Pero0123/IOT-Project/Website/project picture.png

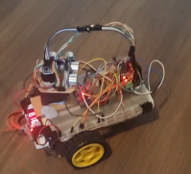
Website/project picture.png
