Pero0123/IOT-Project/Project Report.docx

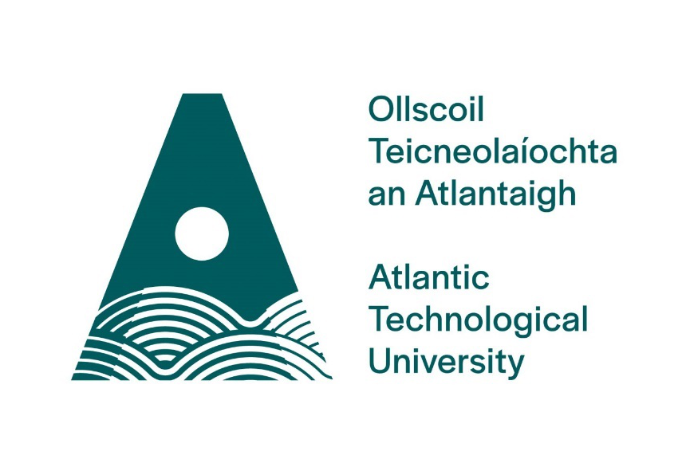
[picture p2: figure]

Autonomous Path Finding Vehicle

Internet of Things Project Proposal

Pero Schwitalla

BEng(H) in Software & Electronic Engineering 2nd Year

Atlantic Technological University

2023/2024

# Autonomous Vehicle Poster

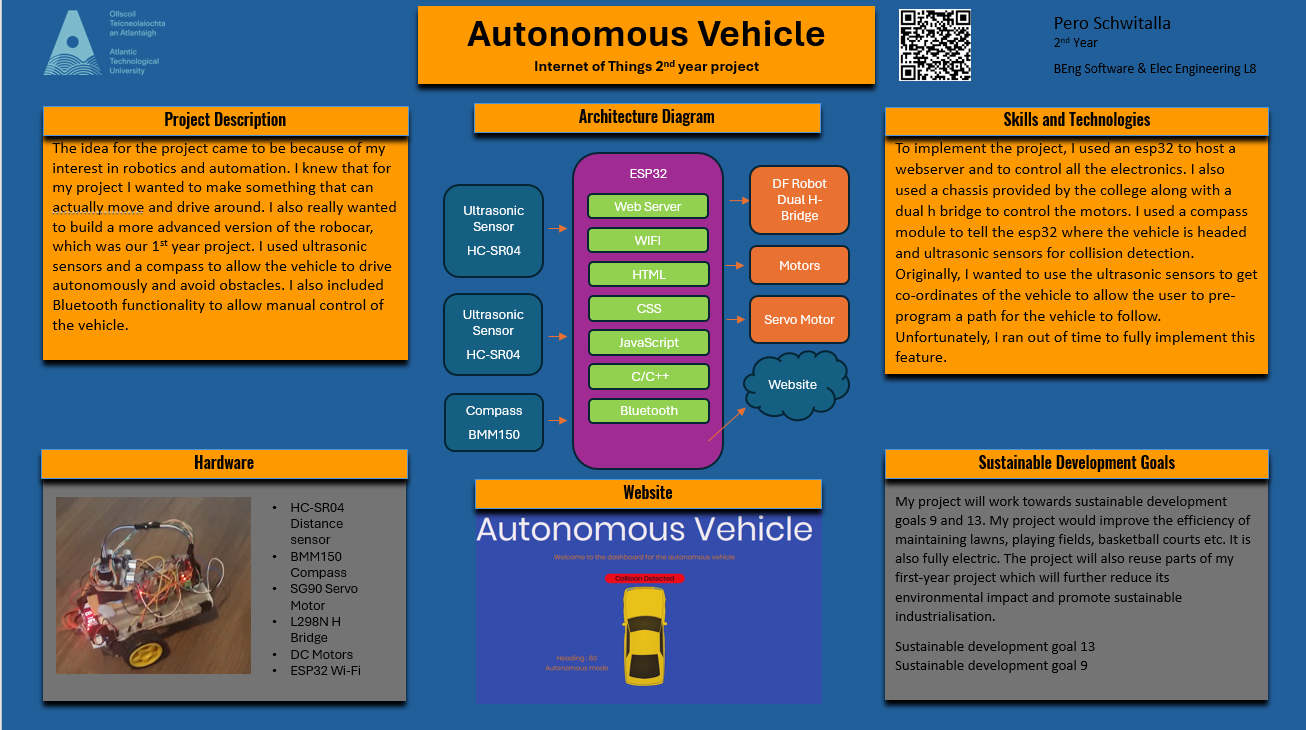
[picture p3: figure]

# Project Hardware

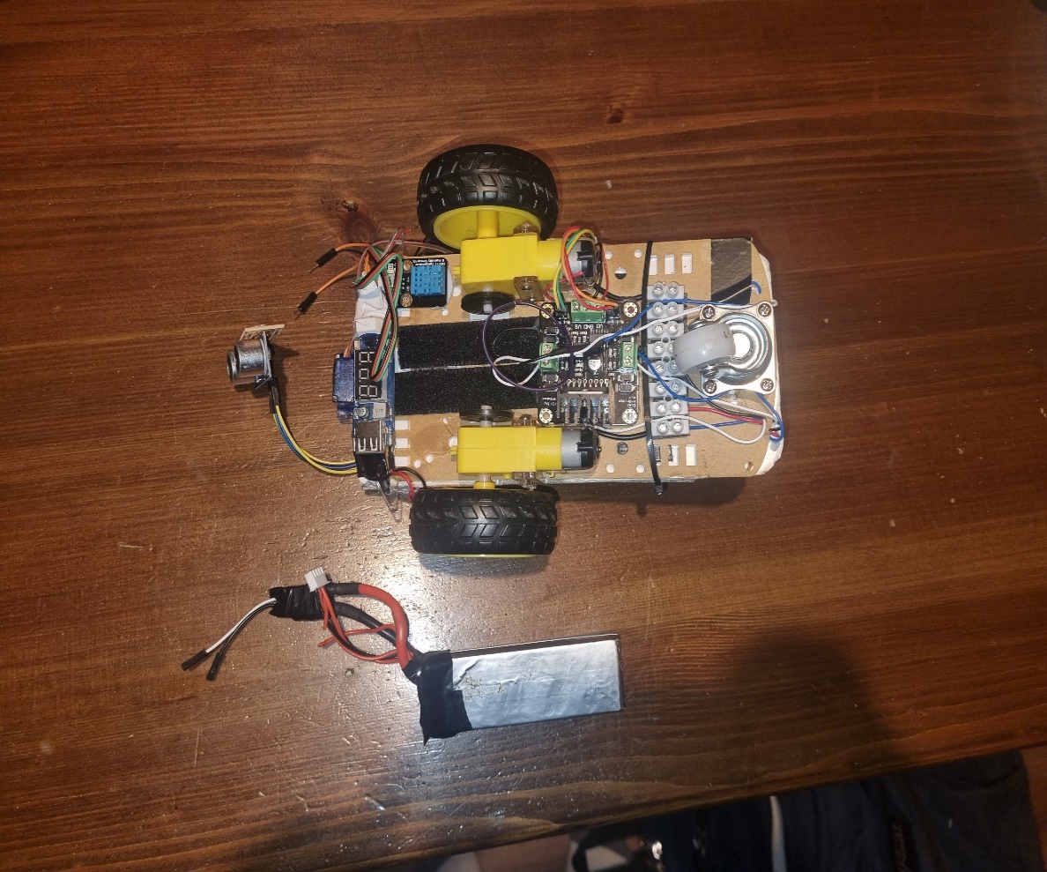
[picture p4: figure]
Bottom view
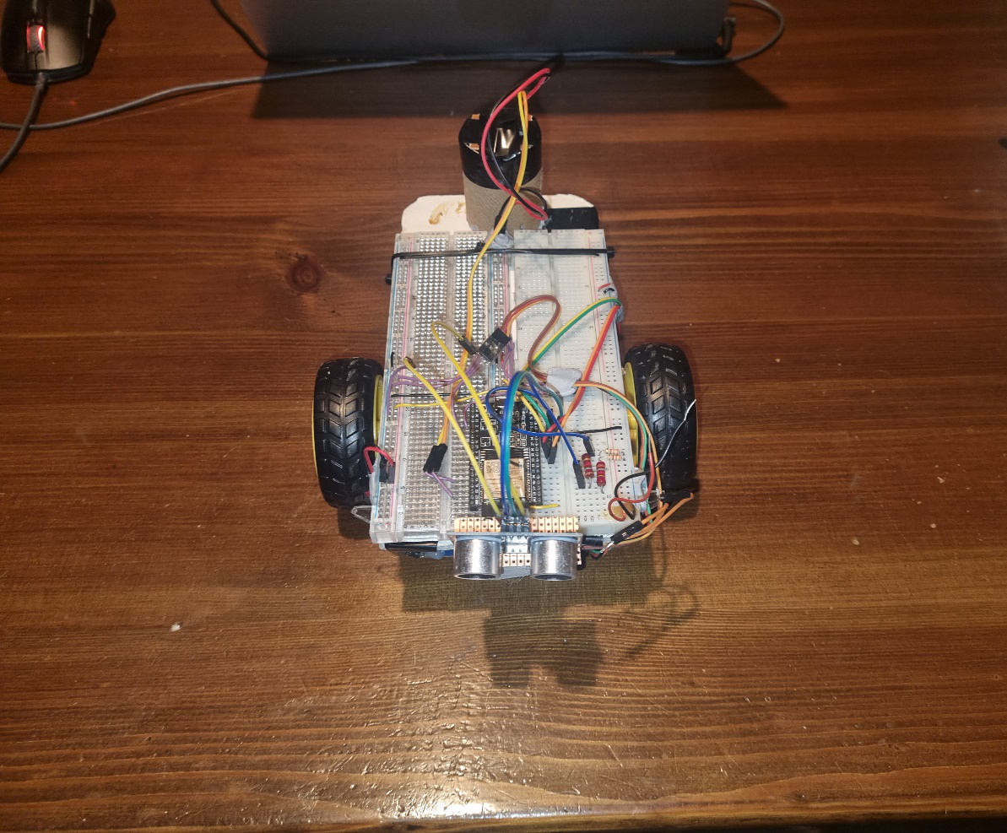
[picture p5: figure]
Top View

# Declaration

This Project is presented is partial fulfilment of the requirements for the degree of Bachelor of Engineering is Software & Electronic Engineering at the Atlantic Technical University, Galway.

This project is my own work, except where otherwise accredited. Where the work of others has been used or incorporated during this project, this is acknowledged and referenced.

# Acknowledgments

I wish to acknowledge and thanks the people who have helped me with this project.

Nathasha Rohan

Brian O’Shea

Brian Contello

Ben Kinsella

Pat Hurney

# 1. Summary

The cleaning and maintenance of lawns, pitches, basketball courts etc are very repetitive tasks which could be automated with the right technology. With an interest in automation and robotics, I am developing an autonomous vehicle platform, which could complete these tasks to a high standard. This will be achieved by using an array of sensors for obstacle detection, environmental monitoring, and navigation. The vehicle will be connected to a webserver, which can used to manually control the vehicle, select the operation mode, and monitor the vehicles status. Telemetry data, such as temperature and humidity can also be viewed on the webpage. This will make it possible to automatically do a wide variety of tasks such as cleaning, cutting grass and ice resurfacing.

The scope of this project involved the integration of hardware and software components to enable the collection and processing of data to autonomously navigate through unknown environments. It also includes the design and implantation of user-friendly interfaces and networking to create a friendly and pleasant user experience.

This project will work towards sustainable development goals 9 and 13. The project would improve the efficiency of maintaining lawns, playing fields, basketball courts etc. It is also fully electric. The project will also reuse parts of previous projects which will further reduce its environmental impact and promote sustainable industrialisation.

1. Sustainable development goal 13 – take urgent action to combat climate change and its impacts.
2. Sustainable development goal 9 – Build resistant infrastructure, promote inclusive and sustainable industrialisation and foster innovation.

I approached this project by breaking it up into separate sections. I wanted to get the sensors working individually before putting it all together. I also created functions to easily use the sensors and control the motors efficiently. Once all the basic functions of the project where individually implemented, I started to build the webpage.

From this project I learned how to deal with noisy data from sensors. I used a magnetometer to create a compass for navigation, but this proved very difficult as signal is very noisy. By calibrating the compass and averaging the values over time I managed to get reliable readings. I also learned that testing and prototyping is very important and can avoid large problems further down the line.

The main technologies used are C/C++ programming, data analyses and processing, noise reduction/blocking, website design, user interface design, Html, CSS, JavaScript fetch API.

I achieved my goal of creating an autonomous vehicle that can be used as a platform for automating certain tasks, however I ran into many problems along the way and had to come up with creative solutions. To achieve this, I had to change the design of the project in major ways.

# 2. Project Plan

I planned the project during the research phase. The plan was altered over time as the project changed during development. However, I stuck to the original plan as closely as I could.

## 2.1 Semester 1 Plan

Week 1 and 2

- In depth research for the project. Acquire components and start testing.

Week 2 and 4

- I will build the ultrasonic location system. I will also research and write the code to find the coordinates of the ultrasonic receivers.

Week 4 and 5

- I will test the accuracy of the ultrasonic location and fix any bugs. I will also begin building the vehicle. If possible, I will use the robocar that I built as my first-year project.

Week 6 and 7

- I will research and code the path finding. I will also write all the functions I need to control the vehicle.

Week 8-10

- I will create a basic implementation of the website. This should include basic features such as manual control, telemetry and have the basic layout of the final webpage. Do a lot of testing and bug fixing during this time to ensure the project is in good shape for the initial project demonstration.

Weeks 11-12

- Finalise the project demonstration and start filming for the demonstration video. Create and edit the demonstration video.

## 2.2 Semester 2 Plan

Week 1

- Order new magnetometer and calibrate it. Test and debug the driveTowardsHeading() function.

Week 2

- Unifi all the drive functions into a single versatile function.
- Continue debugging the compass.

Week 3-5

- add servo for the front ultrasonic sensor. Write to detect obstacles using the ultrasonic sensor.

Week 5-7

- Rebuild the website using flexbox, implement fetch API to send commands from the website back to the ESP32.
- Implement the website controls on the ESP32.
- Send telemetry to the website.

Week 7-9

- Start work on the project poster.

Week 9-12

- Implement obstacle avoidance function.
- Finalise project features.
- Bug testing and tidy up code and website.
- Write project report and film and edit the demonstration video.

## 2.3 Changes to the plan

During development of the project, significant changes were made to the design. As I result the project plan also changed. The removal of the ultrasonic location system was the biggest change. During development of this system, it became apparent that it would be very difficult to implement, and the accuracy was limited to approximately within 5-10 cm during testing.

The alteration to the plan came because of issues with the accuracy and reliability of the magnetometer. I had to order a different sensor and rewrite all the code as result. To avoid this impacting and delaying the rest of the project, I ended putting this part of the project on hold and working on other aspects first.

# 3. Project Architecture

## 3.1Architecture Diagram

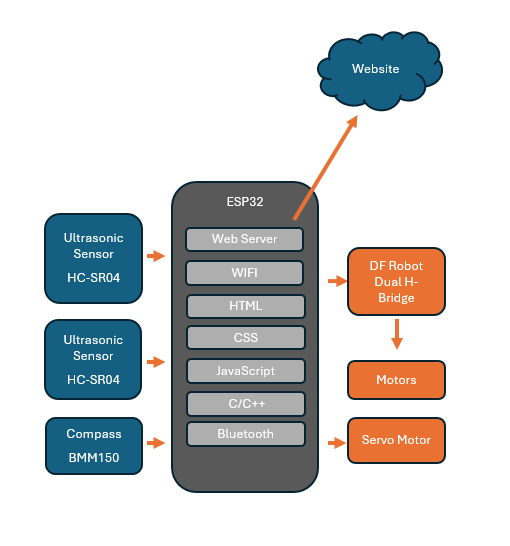
[picture p6: figure]

# 4. Development Platform and Tools

## 4.1 Development Platform

The ESP32 is a low power microcontroller with built it Wi-Fi and Bluetooth capability. It runs at 240Mhz compared to 16Mhz clock speed of the Arduino Uno. These features make it a perfect choice for an IoT project. It allows a responsive web server to run while running the other code simultaneously. It has 4Mb of flash memory allowing large programs and websites to be stored. [1]

## 4.2 Development Platform (IDE)

The ESP32 can be programmed using the Arduino ide, making it easy to develop and build projects with. It also supports many of the same libraries as the Arduino. The Arduino IDE has a versatile serial monitor and code debugger to aid development and testing. The Arduino IDE also allows for easy management of libraries and has support for multiple files, making it easy to write and organise custom functions.

## 4.3 Web Development Platform

To develop the webpage, I used Visual studio code as my code editor. Offers great debugging and supports an extension for a live webpage view, making it easy and quick to make changes the webpage. I also used the Microsoft edge 3D debugger to debug the webpage. This feature makes it easy to debug layering issues Z-index.

Once I finished the webpage, I used the Arduino IDE to store it in literal strings, which can be stored on the ESP32.

## 4.4 Organising and Planning

I used OneNote to keep a development log of my project. I used Trello to make rough long-term plans. This made it easy to get an overview of the whole project at a glance.

# 5. Sensors

I used 3 ultrasonic sensors to detect obstacles in front and to the side of the vehicle. I used a DHT11 to measure temperature and humidity to make distance measurements more accurate and to display the temperature and humidity on the webpage for the user. I also used a magnetometer to detect which way the vehicle is facing.

## 5.1 HSR-04 Ultrasonic Distance Sensors

The HSR-04 provides distance measurement with an accuracy of +-3mm and a field of view of 15 degrees. It operates at 40KHz making it far outside the range of most sounds that could interfere with the measurement. The sensor works by sending out a 40KHz sound in 8 bursts and measuring how long it takes for the signal to return. The output on the Echo pin is in proportion to the time it takes for the signal to return. [2]

To use the ultrasonic sensor a HIGH signal must be applied to the trigger pin for 10us.The Arduin pulseIn() function can then be used to measure the length of the pulse at the Echo pin. The length of the pulse is multiplied by the speed of sound and divided by two to account for the fact the sound has to travel to the object and then back again. The final distance can be calculated using the following formula:

distance = (pulseIn × (340M/S) / 2.

pulseIn is a blocking function. This means that while it is waiting for a pulse, it will effectively stop code execution. To optimize my final code, I adjusted the maximum wait time of pulseIn() to 3000us, which is how long it takes for sound to travel 50cm and back. This means that the maximum amount of time spent waiting for all three sensors to measure a distance will be close to 1ms. Since I don’t need the sensors to measure anything beyond 30cm, it will not have any effect on the functionality of my project. To detect if pulseIn timed out or an obstacle is close, I check if pulseIn returned a 0 or a non-zero value.

## 5.1.1 Ultrasonic Sensor code

## 5.2 DHT-11 Temperature Sensor

The DHT-11 is a temperature and humidity sensor with an accuracy of +-2 degrees Celsius and +- 5%RH. The DHT-11 uses a thermistor and a capacitive humidity sensor for measuring. The output is a digital signal using a proprietary communication protocol [3]. It is used in this project to adjust the distance calculations for the ultrasonic sensors as the speed of sound is dependent on the temperature and humidity of the air it is traveling through [4]. The DHT11 can operate at both 3.3 volt and at 5v. I choose to operate it at 5v as the ESP32 input pin work between 0 and 3.3v.

## 5.2.1 DHT11 Code

## 5.3 QMC5883L Magnetometer

The QMC5883L is a three-axis magnetic sensor. It is a surface mount device that is mounted on a breakout board for easy installation. It is targeted for high precision applications such as virtual reality gaming, drones and robot use. It supports the I2C interface for data transfer. The sensor operates between 2.16V and 3.6V with a low power consumption of 75uA. [5]

In this project it is used to determine the direction the vehicle is heading. This allows me to keep the vehicle driving in a specific direction and to make precise turns, removing the need to precisely calibrate the motor speed to turn a specific direction. The main downside to using a magnetometer to determine the vehicle heading is that it is extremely sensitive to magnetic and electromagnetic fields. To work around this issue, the sensor is mounted on a pole on the back of the vehicle to keep it away from the motors and any other electro magnetic interference. Using magnetic shielding was considered, but it has limited effectiveness and is expensive.

## 5.3.1 QMC5883L Code

# 6. Motors

I used two 360-degree servo motors as propulsion for my vehicle. Originally, I used two dc motors with a dual H-bridge, but this turned out to be difficult to control precisely. The main issue was that, when running the dc motors at a low duty rate it was very difficult to keep them both moving at the same speed leading to the vehicle veering to one side. The relatively large dc motors also caused large current spikes which could shut of the ESP32 momentarily, causing the program to reset. Using 360 servo motors allows for easy and accurate control of the vehicle while preventing any large current spike due to the small motors and high gear ratio. This allows me to use a smaller battery and simply the code and hardware.

## 6.1 Servo Motors

The parallax continues rotation servo (#900-00008) is a non-encoded 360-degree servo motor. It can operate between 0 and 50 rpm clockwise and anticlockwise. It operates between 4V and 6V DC. To control the speed of the servo, a PWM signal is applied to the signal pin. A HIGH pulse of 1.3ms turns the servo at full speed clockwise. A High Pulse of 1.7ms turns the servo at full speed counterclockwise. To stop the servo, a 1.5ms HIGH pulse is applied to the signal pin. [6]

To use the parallax servo in my project, I made use of a modified Servo library [7]. This allows me to use the servoWrite() function to control the speed and direction of the servo motor. Since the library is originally designed to be used with regular 180 degree servos, an angle between 0 and 180 degrees is used as the argument is the servoWrite() function. To stop the servo, the argument is 90 degrees. For full speed clockwise rotation, the argument is 0 degrees and for full speed anti-clockwise rotation, the argument is 180 degrees.

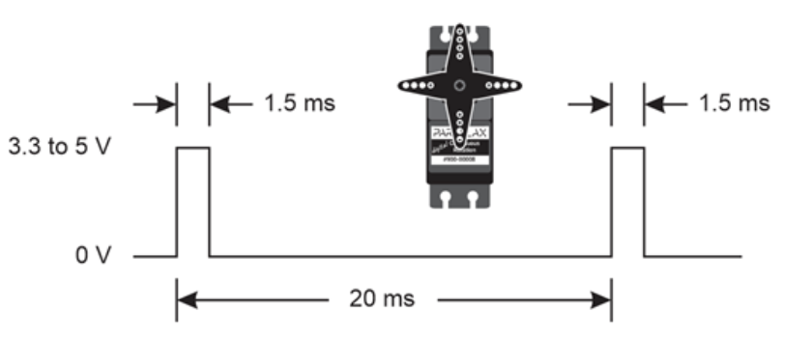
[picture p7: figure]
Servo PWM control signal diagram

## 6.1.1 Servo Code

# 7. Web Server

# 8. Problem Solving

While working on the project, I encountered many problems and complications. A few weeks into the project I realized that the scope of the project is too big and that I would not be able to successfully implement every feature at a high quality. After testing and prototyping the ultrasonic location system, it became apparent that it was a very complex system to get right. I decided to focus on other aspects of the project first and later decided to remove the location system all together.

To solve problems in my project, I worked with other students and with lecturers. I also used numerus online resources such as the Arduino forums, datasheets, and guides to help diagnose and fix problems. Below I outlined the major problems I encountered while working on the project.

## 8.1 Magnetometer Interference

The QMC5883 was giving very unreliable readings when using the example provided by the library I was using. I found out that the specific gy271 breakout board that I sourced was using the cheaper QMC5883L sensor instead of the HMC5883L sensor. I sourced a library designed for this sensor and found it more accurate but still unreliable.

After some experimentation I found that placing the sensor on a pillar on the back of the vehicle away from the magnets in the motor fixed this issue and I got reliable and accurate readings from the compass.

I considered using magnetic shielding foil, but shielding is expensive and less reliable than just placing the sensor away from any interference. The sensor can’t be entirely shielded either because it needs to be able to read earth’s magnetic field to be used as a compass.

## 8.2 Ultrasonic Location System

Splitting the ultrasonic sensors into transmitter and receiver pairs was effective when the sensors were pointed directly are each other. When the sensors were pointed more than 5 or 10 degrees away from each other, they gave inaccurate readings by about +- 2cm per degree. I modified one of the transmitters and receivers to have a wider field of view. This resulted in slightly more accurate readings but still not good enough for my application. Since I was unable to find a solution that was within the scope of this project, I had to cut the location and path finding aspect from my project. Below are two images of the modified sensors.

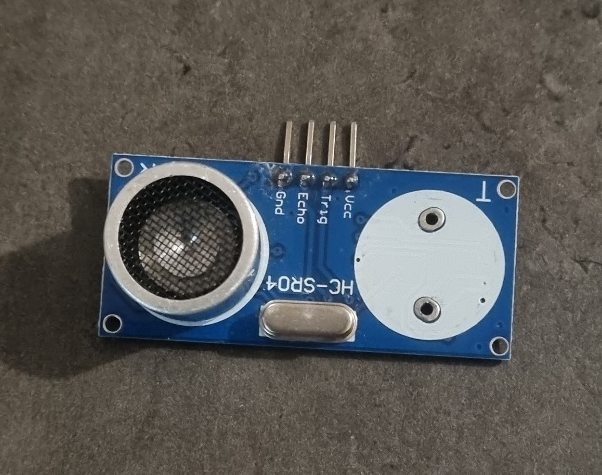
[picture p8: figure]
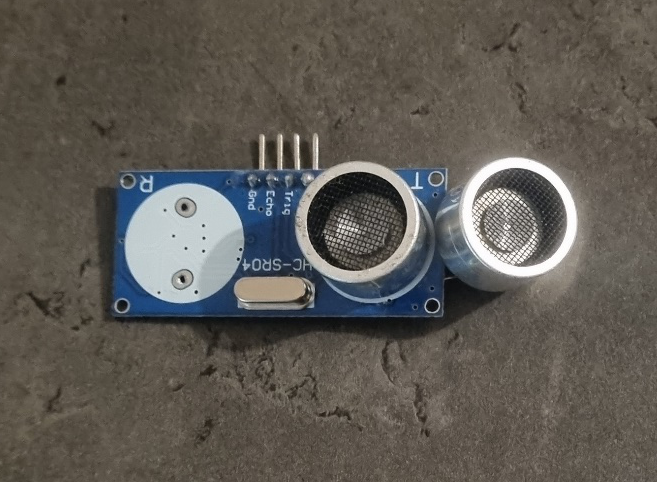
[picture p9: figure]

## 8.3 Vehicle Veering to one side

The vehicle was always veering to the right and then snapped back to the original heading. Initially I thought this was an issue with the compass drifting, or interference. After investigating the problem further I realised that the left DC motor was slightly slower than the right motor causing the vehicle to always veer slightly to the right. Initially to solve this problem, I ran the left motor with a slightly higher duty cycle by about 10%. This improved the problem, but it still wasn’t perfect, and it wasn’t a clean solution and made the code more complicated and messier.

I decided to use continues rotation servos instead of the DC motors for my final hardware. Servo motors are extremely precise and easy to code. Servo motors are also easy to control at low speeds while DC motors are very unreliable at a duty cycle of less than 30%, which is still faster than I want the project to drive at.

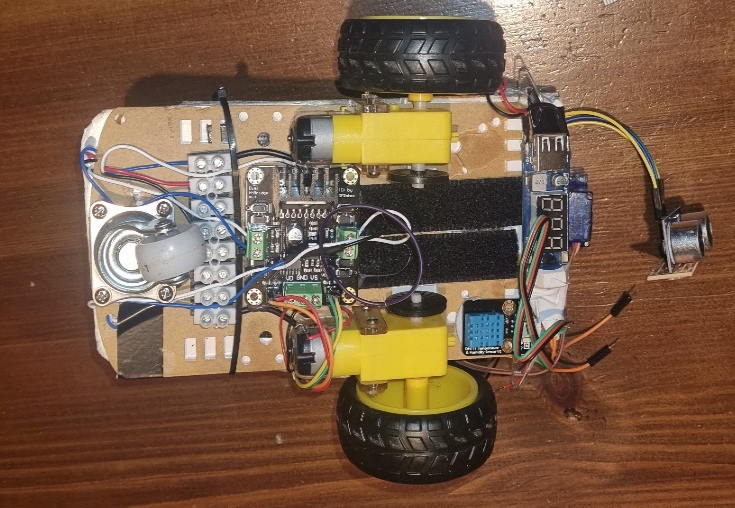
[picture p10: figure]
Bottom view

Figure 1 Project with DC motors and H-Bridge

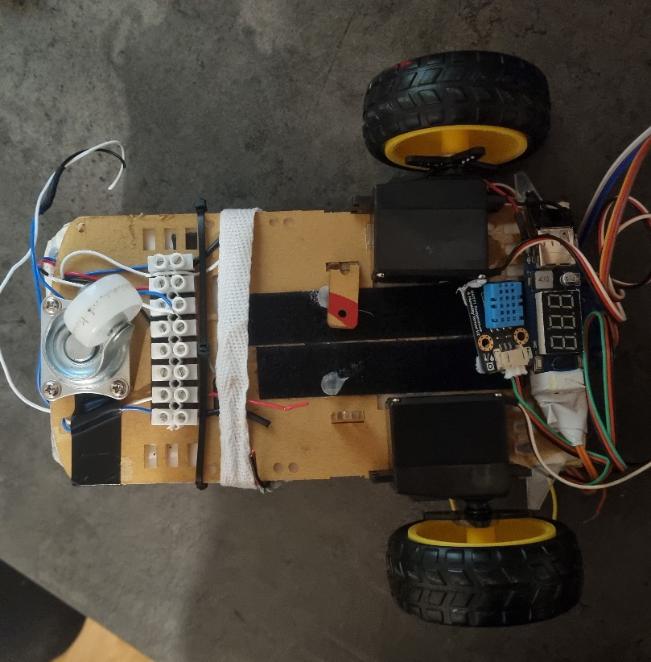
[picture p11: figure]

Figure 2 Project with Servo Motors

## 8.4 ESP32 not connecting to PC

Near the end of the project, the ESP32 stopped connecting to the pc or laptop. I tried using multiple USB cables, updating the Arduino IDE and using different computer. I then tried the legacy version of the Arduino IDE, which gave me an error code relating to the bios mode when trying to upload my code. I locked up the error and found a forum post with a solution. Holding the boot button on the ESP32 while uploading code solved the issue.

# 9. Impact of Project on Sustainability

I considered the impact of my project on the united nationals sustainability (SDGs)goals. I also considered the impact my project would have sustainability during the conception and design of my project to ensure to ensure that my project works towards the SDGs as much as possible.

I concluded that my project directly works towards two of the SDGs

1. Sustainable development goal 13 – take urgent action to combat climate change and its Sustainable development goal 13 – take urgent action to combat climate change and its impacts.

I re-used components from previous projects to build my autonomous vehicle. This reduces toxic e-waste and reduces the carbon footprint of my project. My project is also fully electric, leading to close to zero emissions if the electricity is generated using renewable sources.

2. Sustainable development goal 9 – Build resistant infrastructure, promote inclusive and sustainable industrialisation and foster innovation.

My project is made mostly from re-used components leading to sustainable industrialisation.

# 10. Conclusion

In conclusion, I learned a lot from designing and building this project. I think that overall it went well.

The outcome of this project is:

A website with live telemetry and controls, which is designed to be accessible.

An autonomous cleaning robot with ultrasonic sensors for obstacle detection and temperature and humidity sensors for environmental monitoring.

Manual Bluetooth control of the vehicle using a switch on the vehicle.

While I had to make some modifications to the project due to time constraints, I think my project still achieves the functionality outlined in the project proposal but using a different method. In the future, I would like to further develop the project to be capable of line paint and following specific pre-programmed paths using a local location system.

# 1. References

[1] | DOIT, “Esp32 Datasheet,” [Online]. Available: https://roboeq.ir/files/id/4034/name/ESP32%20MODULE.pdf/. [Accessed 30 08 2024].
[2] | SparkFun, “HCSSR04 Datasheet,” sparkfun, [Online]. Available: https://cdn.sparkfun.com/datasheets/Sensors/Proximity/HCSR04.pdf. [Accessed 08 01 2024].
[3] | MOUSER, “DHT11 datasheet,” [Online]. Available: https://www.mouser.com/datasheet/2/758/DHT11-Technical-Data-Sheet-Translated-Version-1143054.pdf. [Accessed 08 01 2024].
[4] | W. &. G. M. &. W. T. &. v. d. G. C. van Schaik, “High Accuracy Acoustic Relative Humidity Measurement in Duct Flow with Air. Sensors,” 08 2010. [Online]. Available: https://www.researchgate.net/figure/Speed-of-sound-vs-temperature-and-relative-humidity-according-to-2-p-1013-kPa-314_fig1_51873087. [Accessed 10 01 2024].
[5] | “3-Axis Magnetic senosr QMC5883L datasheet,” [Online]. Available: https://github.com/e-Gizmo/QMC5883L-GY-271-Compass-module/blob/master/QMC5883L%20Datasheet%201.0%20.pdf. [Accessed 15 01 2024].
[6] | Parrallax, “900-00008-Continuous-Rotation-Servo-Documentation-v2.2.pdf,” Parrallax, [Online]. Available: https://www.parallax.com/package/parallax-continuous-rotation-servo-downloads/. [Accessed 10 01 2024].
[7] | madhephaestus, “ESP32 servo library,” [Online]. Available: https://github.com/madhephaestus/ESP32Servo.

# Appendix 1: Code

# Appendix 2: Bill of Materials

# Appendix 3: Schematic

IoT Project | PERO SCHWITALLA
