Pero0123/IOT-Project/Website/car_topview-300px.png

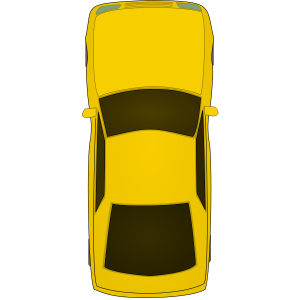
Website/car_topview-300px.png
