Pero0123/IOT-Project/(commit log)

2023-11-21 added files for temperature server
    added files for temperature server
2023-11-27 Added functions for controlling the vehciel. also added code for ultrasonics location
2023-11-27 added new files for servo function
2023-11-27 removed servo functions and replaced with a library for the parralex 360 servo
2023-11-30 test code for servo
2023-12-03 rewrote turning function to allow the user to control the speed off each motor manually including reversing. also small bug fixes and comments
2023-12-06 added function to keep a platformed aligned to a specified heading using the servo
2023-12-13 loads of bug fixes changes and stuff Im not bothered to comment. added code to print imformation about the vehicle to bluetooth.
    [Bluetooth.ino]
2024-04-27 fixed operation of motors. Removed unused code. rewrote functions for compass
    [Bluetooth.ino]
2024-04-28 moslty finished website - needs placeholder buttons replaced
    [ESP32Webpage.ino]
2024-04-28 added webpage to esp32 with strings
